VINEX-Tech/nazer/hardware/enclosure/viewer.html

# NAZER enclosure

Explode lid

Cut-away (front → back, mm)

Drag to rotate · scroll to zoom · right-drag to pan

Outer 111.2 × 104.1 × 35.3 mm · PETG black, logo PLA Fire Engine Red + Orange
