VINEX-Tech/nazer/app/assets/brand/mark.png

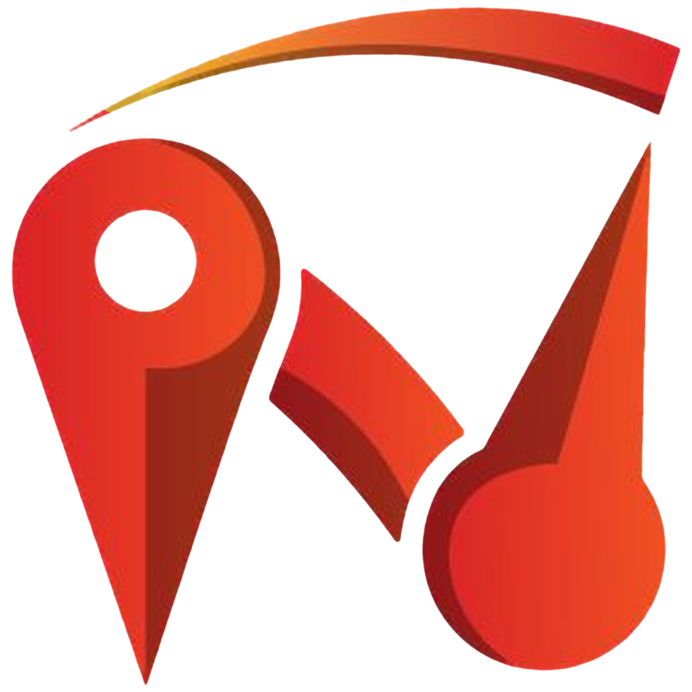
app/assets/brand/mark.png
