VINEX-Tech/nazer/app/assets/brand/mark_foreground.png

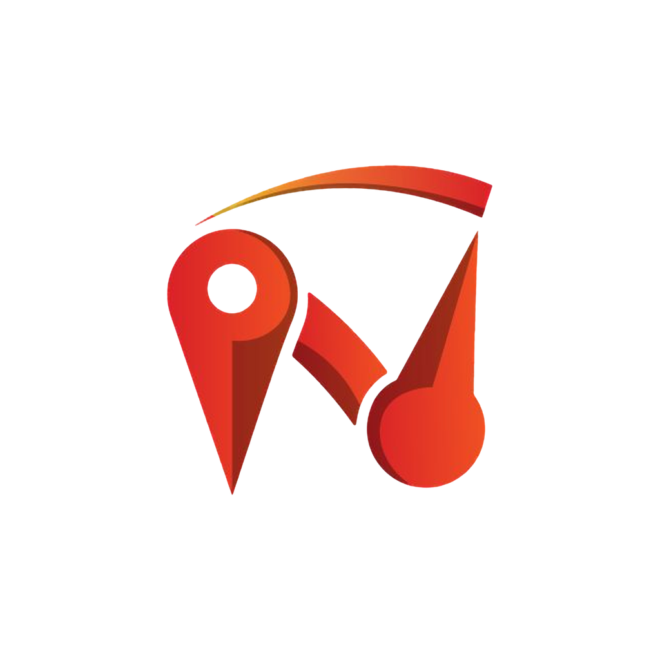
app/assets/brand/mark_foreground.png
