VINEX-Tech/nazer/app/assets/brand/mark_monochrome.png

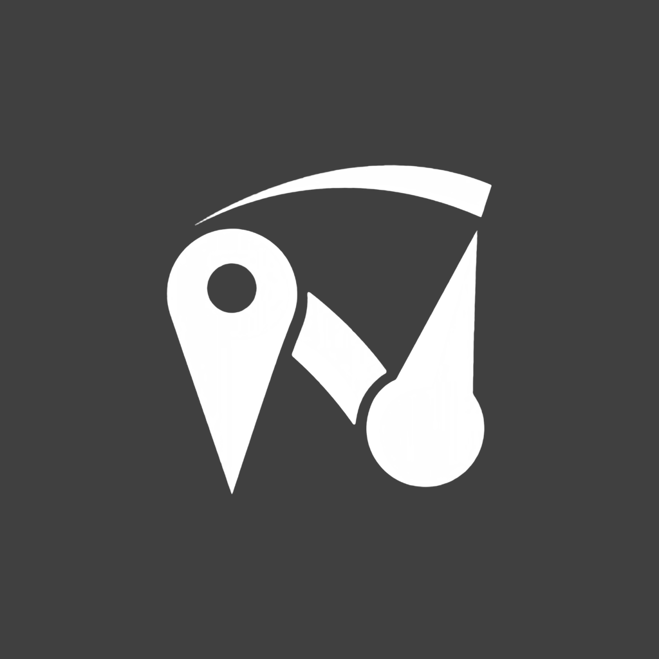
app/assets/brand/mark_monochrome.png
