VINEX-Tech/nazer/hardware/enclosure/out/nazer_lid_logo_text.stl

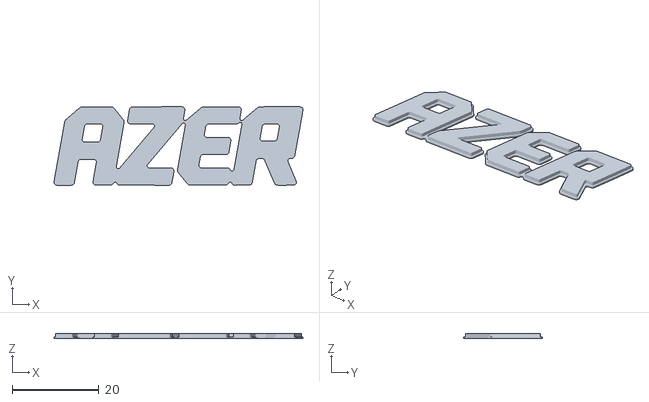
[picture p19: CAD file, 2026-11-01]
hardware/enclosure/out/nazer_lid_logo_text.stl
57.4 x 18.1 x 1.20
