VINEX-Tech/nazer/hardware/tracker-box/stl/logo-text.stl

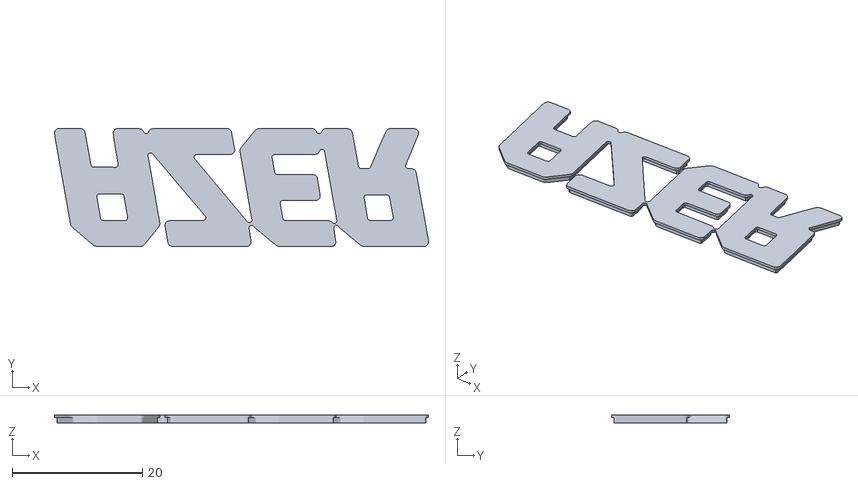
[picture p20: CAD file, 2026-11-02]
hardware/tracker-box/stl/logo-text.stl
57.4 x 18.1 x 1.20
