VINEX-Tech/nazer/hardware/enclosure/out/nazer_base.stl

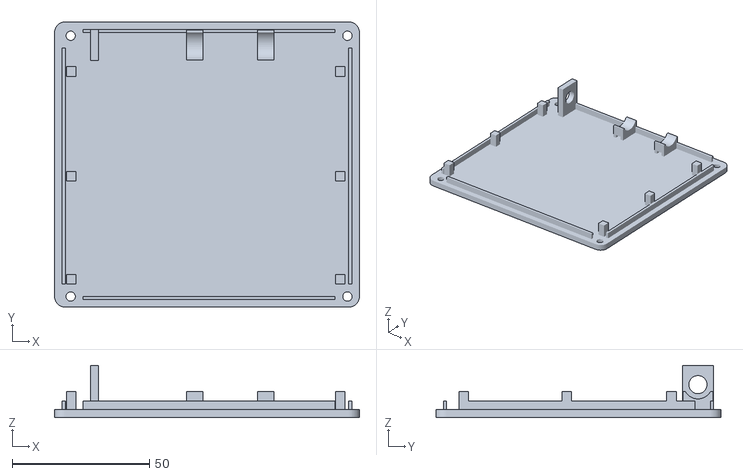
[picture p21: CAD file, 2026-11-01]
hardware/enclosure/out/nazer_base.stl
111.2 x 104.1 x 19.0
