VINEX-Tech/nazer/hardware/tracker-box/stl/port-plug.stl

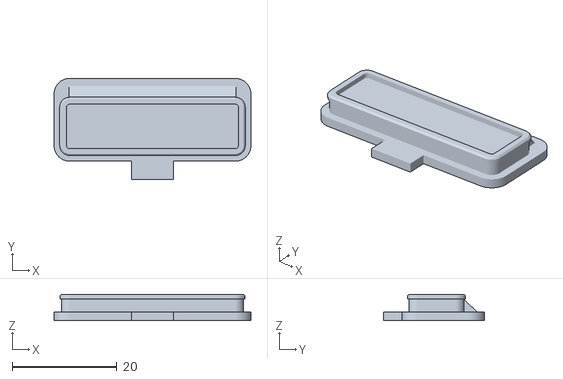
[picture p22: CAD file, 2026-11-02]
hardware/tracker-box/stl/port-plug.stl
37.6 x 19.3 x 5.00
