VINEX-Tech/nazer/hardware/enclosure/out/fitcheck_dummies.stl

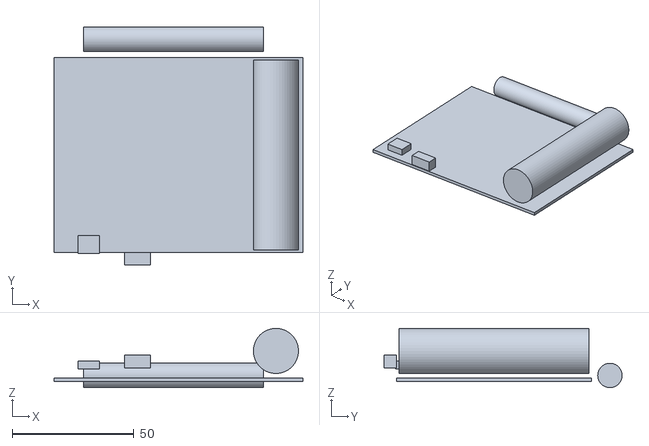
[picture p23: CAD file, 2026-11-01]
hardware/enclosure/out/fitcheck_dummies.stl
102.1 x 97.7 x 24.3
