VINEX-Tech/nazer/hardware/tracker-box/stl/spacers.stl

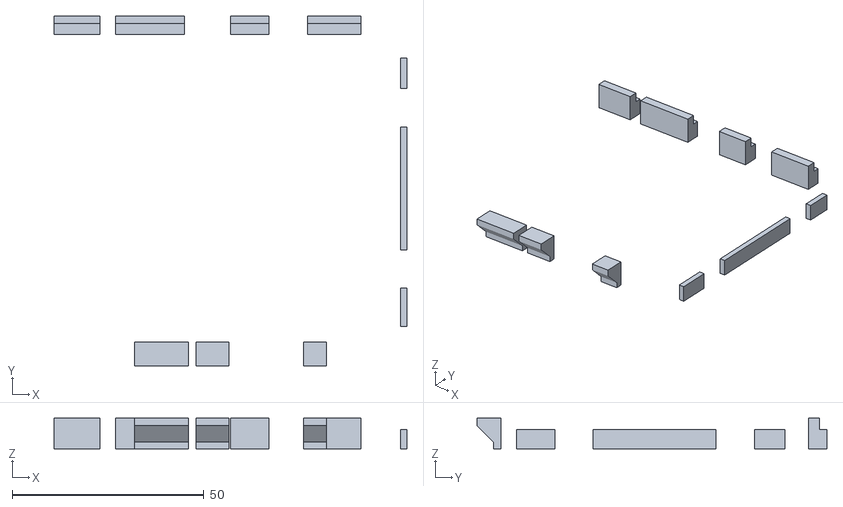
[picture p24: CAD file, 2026-11-02]
hardware/tracker-box/stl/spacers.stl
91.9 x 91.2 x 8.05
