VINEX-Tech/nazer/hardware/enclosure/out/nazer_lid.stl

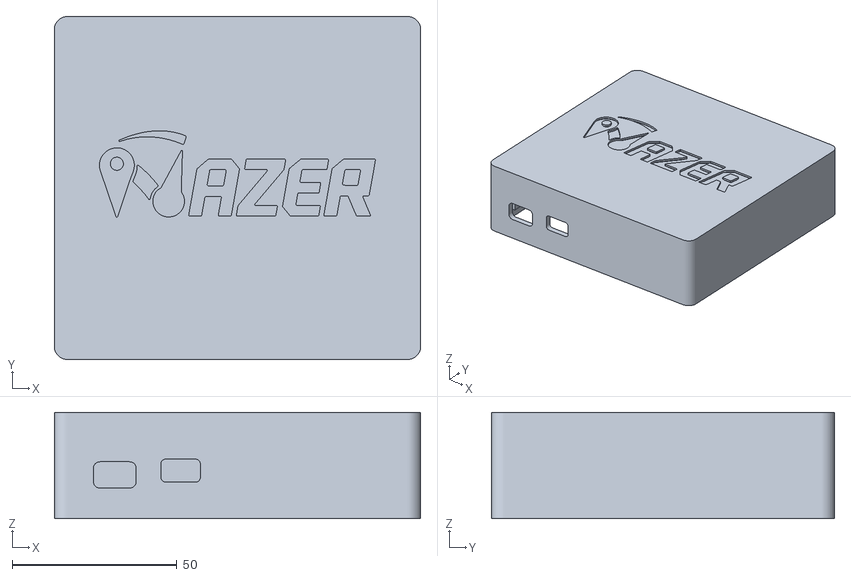
[picture p25: CAD file, 2026-11-01]
hardware/enclosure/out/nazer_lid.stl
111.2 x 104.1 x 32.3
