VINEX-Tech/nazer/hardware/tracker-box/stl/logo-arc.stl

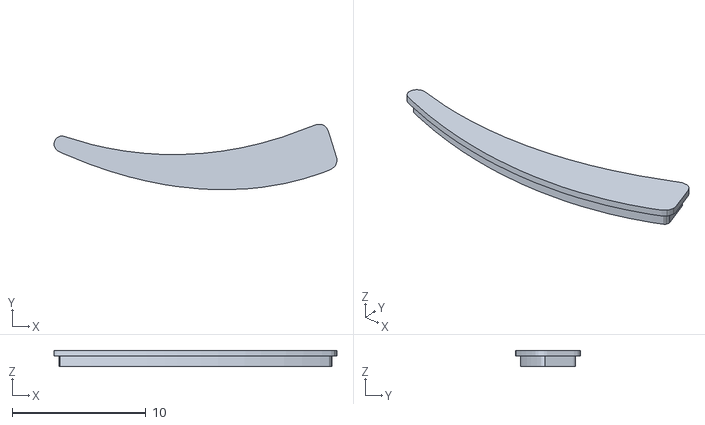
[picture p26: CAD file, 2026-11-02]
hardware/tracker-box/stl/logo-arc.stl
21.2 x 4.90 x 1.20
