VINEX-Tech/nazer/hardware/enclosure/out/nazer_lid_logo_mark.stl

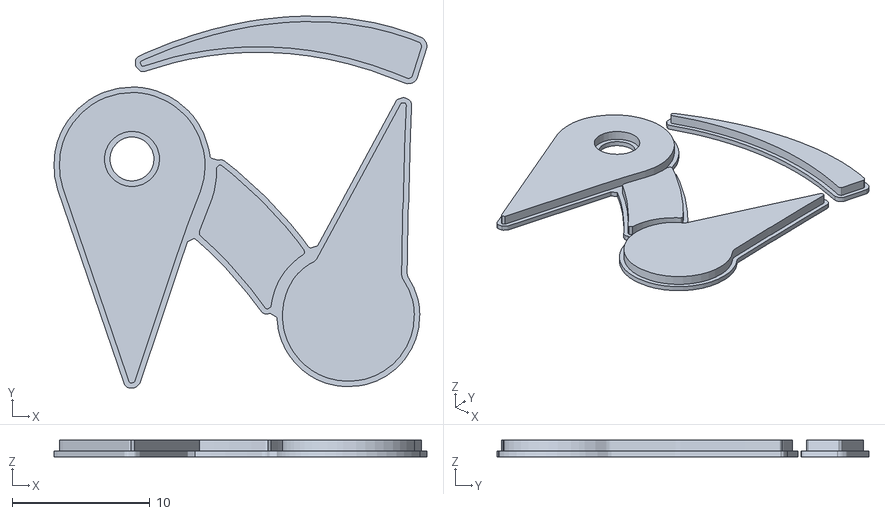
[picture p27: CAD file, 2026-11-01]
hardware/enclosure/out/nazer_lid_logo_mark.stl
27.1 x 27.0 x 1.20
