VINEX-Tech/nazer/hardware/tracker-box/stl/gland-plug.stl

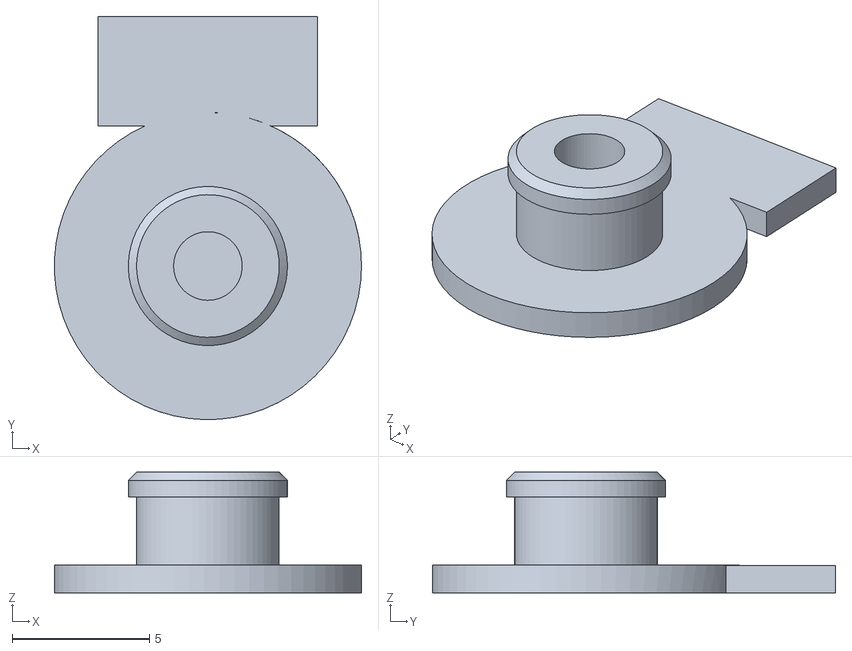
[picture p28: CAD file, 2026-11-02]
hardware/tracker-box/stl/gland-plug.stl
11.2 x 14.7 x 4.40
