VINEX-Tech/nazer/hardware/tracker-box/stl/lid.stl

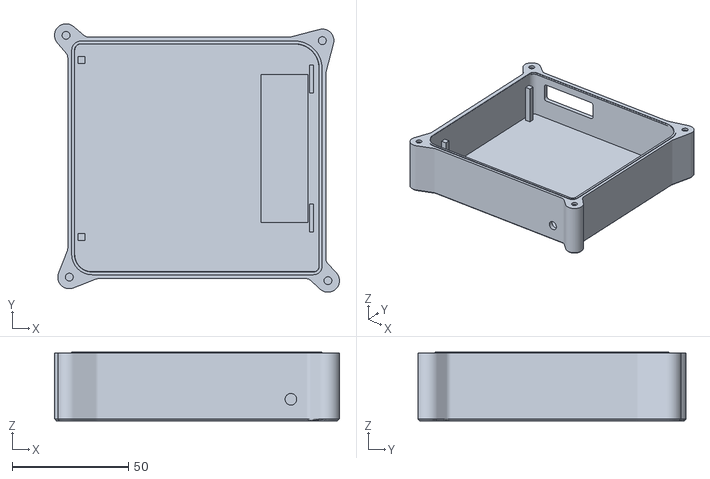
[picture p29: CAD file, 2026-11-02]
hardware/tracker-box/stl/lid.stl
122.7 x 115.6 x 29.6
