VINEX-Tech/nazer/hardware/tracker-box/stl/gasket.stl

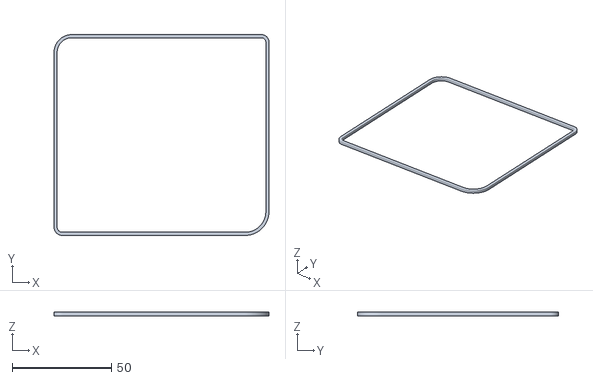
[picture p30: CAD file, 2026-11-02]
hardware/tracker-box/stl/gasket.stl
108.2 x 101.1 x 2.00
