VINEX-Tech/nazer/hardware/tracker-box/stl/base.stl

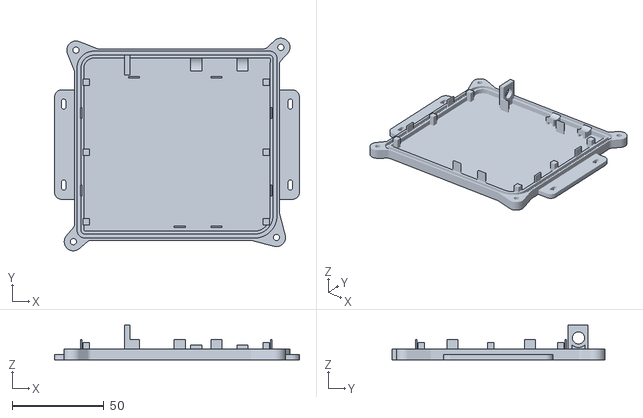
[picture p31: CAD file, 2026-11-02]
hardware/tracker-box/stl/base.stl
133.2 x 115.6 x 19.0
