VINEX-Tech/nazer/hardware/tracker-box/stl/logo-pin.stl

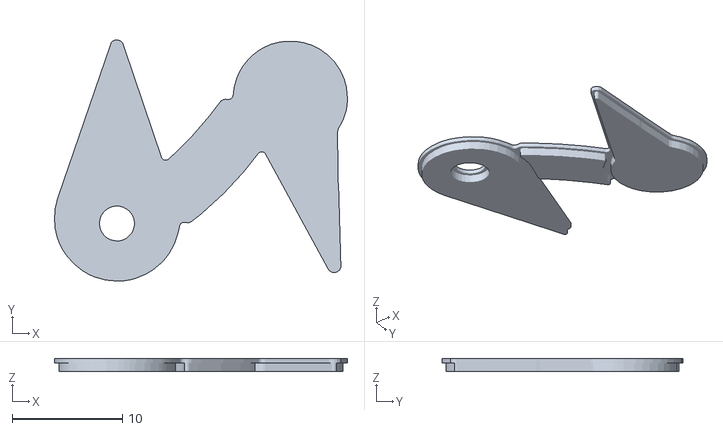
[picture p32: CAD file, 2026-11-02]
hardware/tracker-box/stl/logo-pin.stl
26.6 x 21.9 x 1.20
