VINEX-Tech/nazer/hardware/tracker-box/stl/nut-gauge.stl

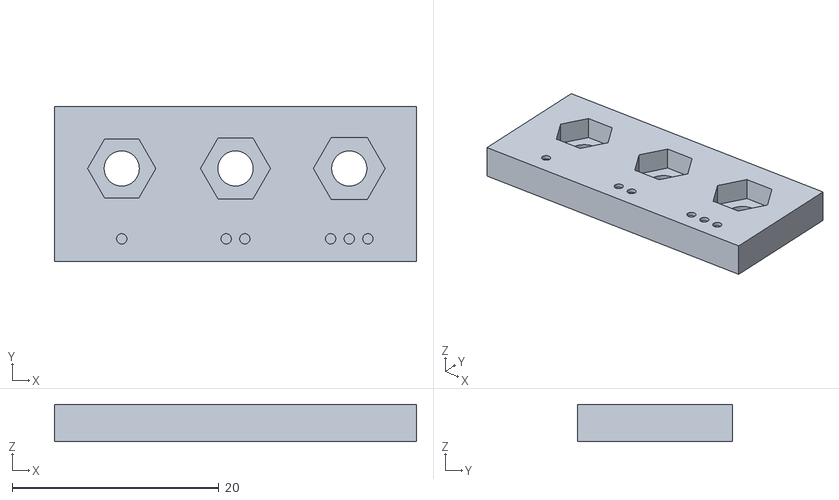
[picture p33: CAD file, 2026-11-02]
hardware/tracker-box/stl/nut-gauge.stl
35.0 x 15.0 x 3.60
