VINEX-Tech/nazer/(list of files, cad)

Other CAD files:
hardware/tracker-box/stl/logo-mark.stl
