VINEX-Tech/nazer/(commit log)

2026-11-01 feat(device): add ESP32 firmware with BLE pairing gate and host checks
    Firmware for the hand-built prototype: GPS and IMU speed, on-device
    road-limit lookup from an OpenStreetMap pack, batched GPRS uploads.
    BLE commands now need the pairing code, and speed limit or vehicle mode
    can no longer be changed by SMS. config.h falls back to the example
    config so a fresh clone builds. Fixes getCovariance() and stops sending
    the fused speed as speed_imu_kmh.
    [known_points.tsv]
2026-11-01 feat(hardware): add parametric prototype enclosure
    Python generator for the PETG box, lid and logo inlay, with the STL
    outputs and a browser viewer.
    [fitcheck_dummies.stl, nazer_base.stl, nazer_lid.stl, nazer_lid_logo_mark.stl, nazer_lid_logo_text.stl]
2026-11-01 feat(platform): add API and admin website with per-device keys and driver tokens
    /v1/app now needs a driver bearer token and only serves the driver's
    own device and records. Device keys are bound to one device (401 for an
    unknown key, 403 for another device's key) and stored hashed. Passwords
    are required. The website uses only /v1/admin routes.
2026-11-01 feat(app): add Flutter app with sign-in and BLE pairing
    Settings gain account sign-in and creation, a bearer token on tracking
    calls and the device pairing code. Payment screens are labelled as a
    demo. pubspec.lock is committed; generated *.g.dart files are not.
2026-11-01 fix(api): require a device claim code, rate limit sign-in and scope event ids
    Registration needs the device's claim code (HMAC of its key), checked
    before the national ID, and links the device with one conditional
    update so concurrent claims have a single winner. A taken national ID
    and an already linked device return the same 409. Register and login
    are rate limited per client IP. Event ids must start with the sending
    device's id.
2026-11-01 feat(device): send the claim code to a paired phone
2026-11-01 feat(app): register the paired device with its claim code
2026-11-01 fix(api): claim devices by single-use challenge-response
    /v1/auth/claim-challenge issues a random nonce valid for 120 s. Register
    burns the nonce in one conditional update before checking the device's
    HMAC answer, so each nonce works once and only for its device. Replaces
    the static claim code.
2026-11-01 fix(device): bond BLE with LE Secure Connections and answer claim challenges
    The link now needs SC + MITM bonding with a static passkey, and every
    characteristic needs an encrypted link. The static claim code is gone;
    the device answers HMAC(key, nonce || device_id) for a paired phone,
    using a self-contained SHA-256/HMAC header with its own host check.
    [config.example.h, main.cpp]
2026-11-01 feat(app): bond before subscribing and relay the claim nonce to the device
2026-11-01 fix(device): fail closed on an unset BLE passkey and limit new bonds to a window
    BLE security and advertising do not start when BLE_PASSKEY is 0 or out
    of range, and a release build environment refuses to compile with the
    placeholder. Display builds show a random passkey per pairing; the
    static passkey stays as the no-display fallback. New bonds are accepted
    for 120 s after boot or a long button press. Policy logic is host-checked.
    [config.example.h, main.cpp]
2026-11-01 docs: record the BLE passkey policy and what is untested on the board
2026-11-01 fix(device): build on newer ESP32 toolchains and pin the platform
2026-11-02 feat(hardware): add the sealed tracker box STLs and render
    [base.stl, gasket.stl, gland-plug.stl, lid.stl, logo-arc.stl, logo-mark.stl, logo-pin.stl, logo-text.stl]
2026-11-02 docs: wiring diagram, drop the board photo, show the box design
