VINEX-Tech/nazer/(notices)

Notices in the files:
README.md:
License: MIT
